puneet1984/PWM-Solar-Charge-Controller/PCB_PWM.png

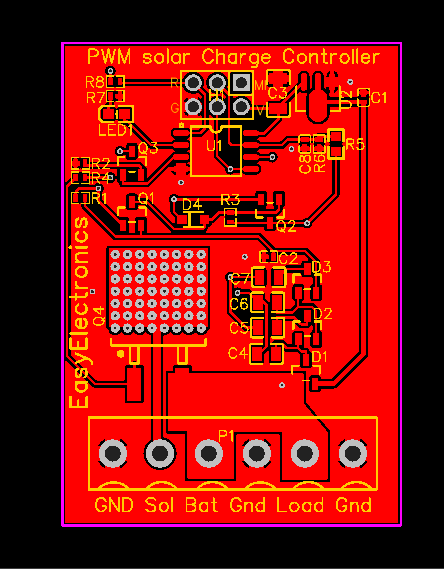
PCB_PWM.png
