puneet1984/PWM-Solar-Charge-Controller/Schematic_PWM.png

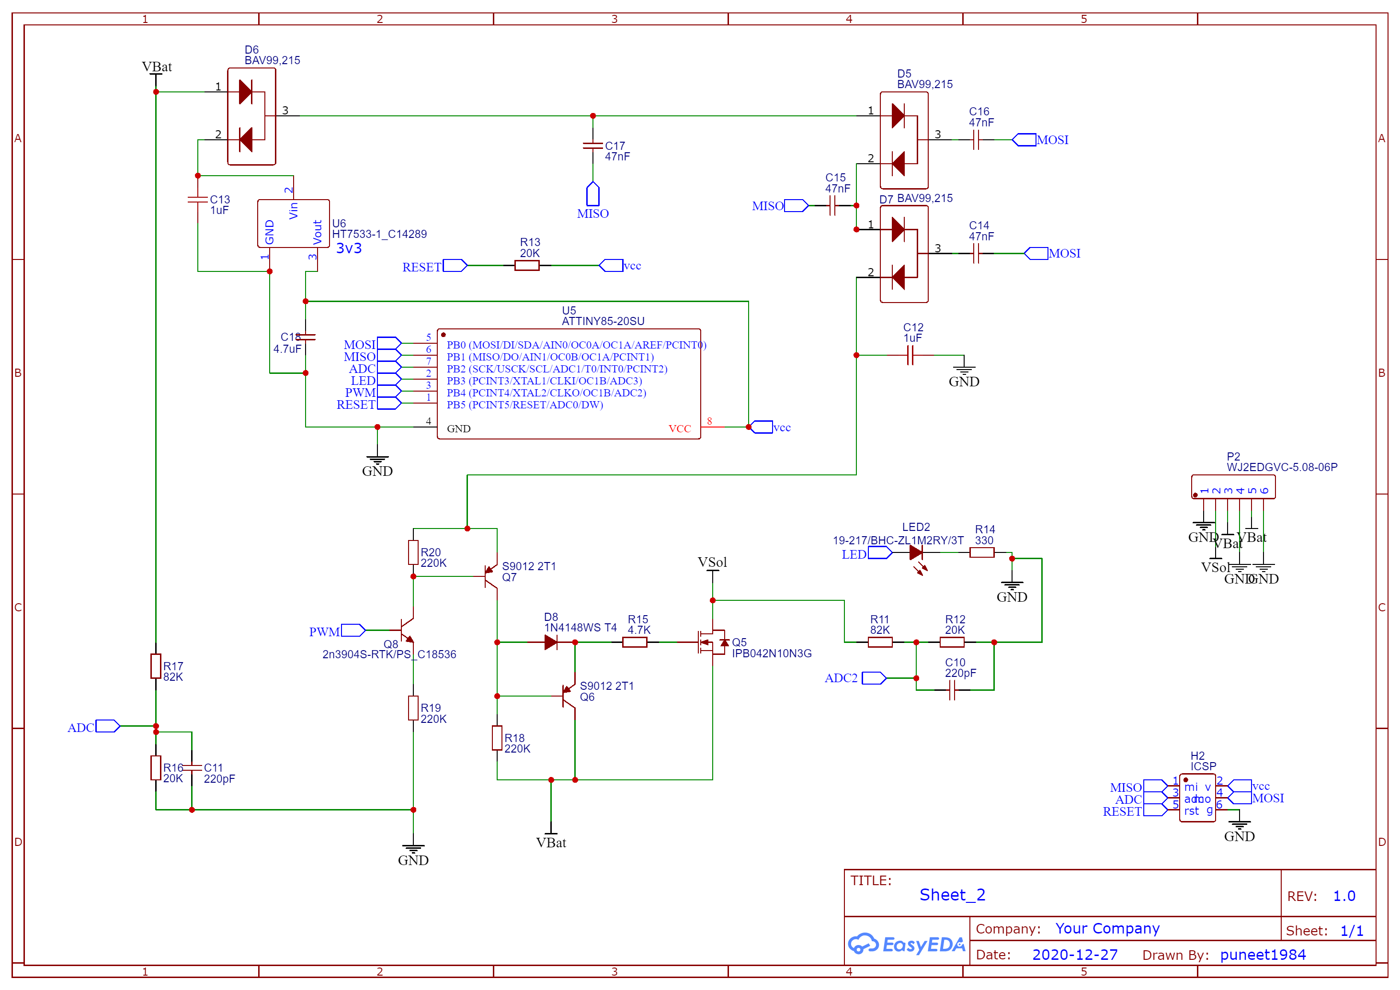
Schematic_PWM.png
