puneet1984/PWM-Solar-Charge-Controller/File_000.jpeg

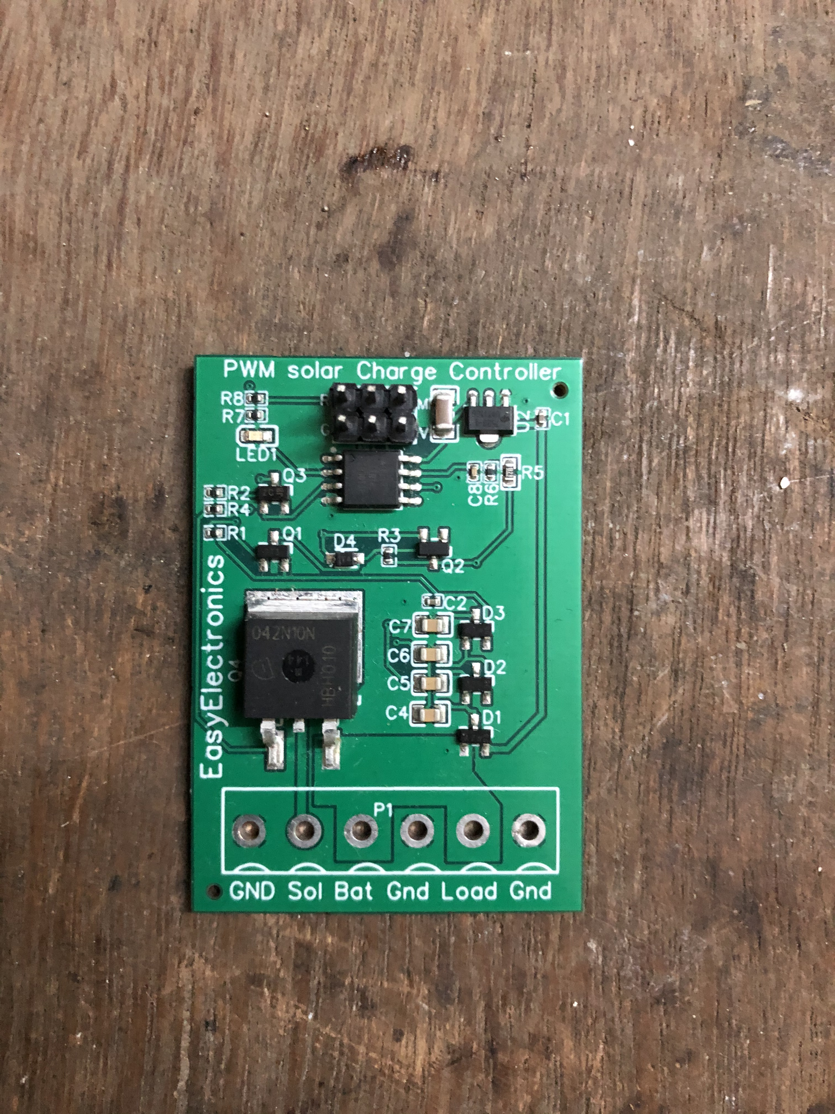
File_000.jpeg
